Maker-Yash/Arduino-8Channel-RC-Transmitter-Receiver/(commit log)

2026-08-16 Initial commit: 8-Channel Arduino Nano RC Transmitter & Receiver system
2026-08-16 Update README clone link for Maker-Yash/Arduino-8Channel-RC-Transmitter-Receiver
2026-08-16 Add GitHub Actions CI workflow for Arduino compilation & update README
2026-08-16 Update Arduino Nano pinout for receiver channels
2026-08-16 Update receiver pin configuration to CH1:D0, CH2-CH8:D2-D8
2026-08-17 Fix RX CH1 output by moving pin from D0 (UART RX) to A0
    [RX_8CH.ino, TX_8CH.ino]
2026-08-17 Support soldered RX0 (D0) pin for CH1 by disabling UART RX hardware override
2026-08-17 Fix LCD UI formatting and limit validation in calibration submenu
    [TX_8CH.ino]
2026-08-20 Remove Arduino CI badge from README
    Removed a badge for Arduino CI from the README.
